dkydivyansh/info-card/mechanical/PCB business card enclosure stand.step

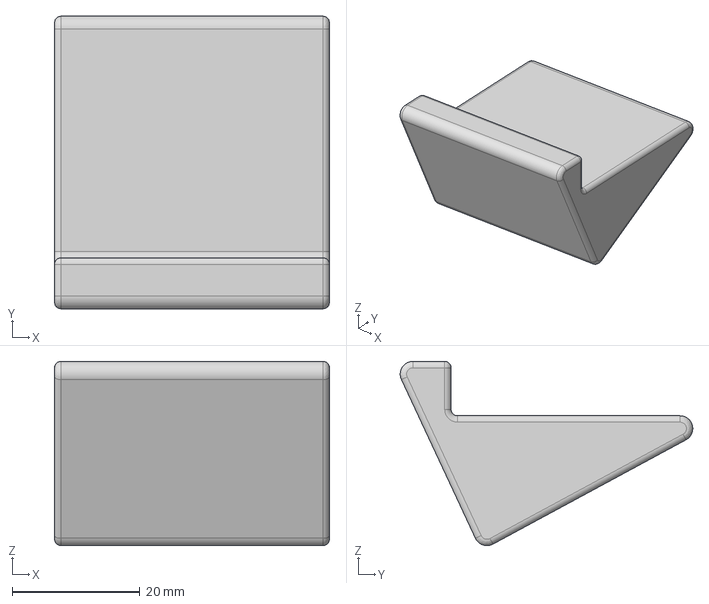
[picture p1: CAD file, 2024-12-27]
mechanical/PCB business card enclosure stand.step
43.0 x 45.8 x 28.8 mm
