dkydivyansh/info-card/mechanical/PCB business card enclosure.step

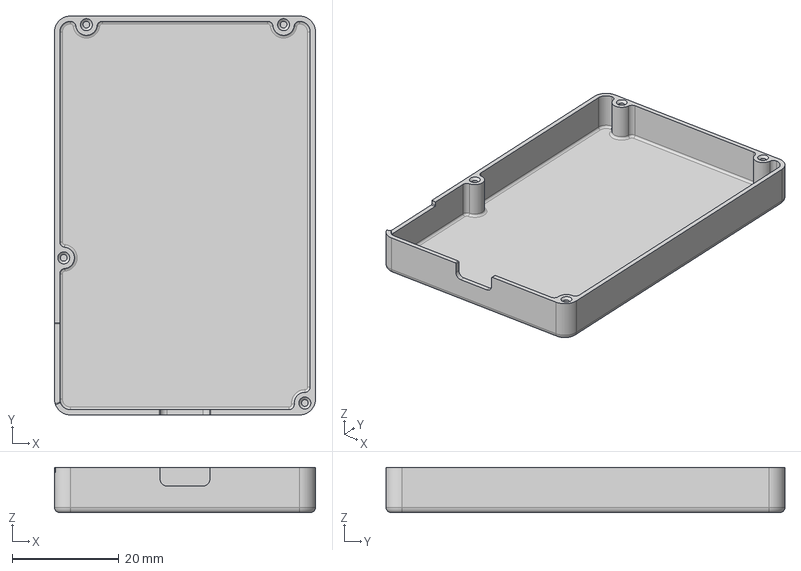
[picture p2: CAD file, 2024-12-27]
mechanical/PCB business card enclosure.step
49.0 x 74.9 x 8.50 mm
